Cyrillinux/attiny2313usbkeys/eagle/gamekeys.png

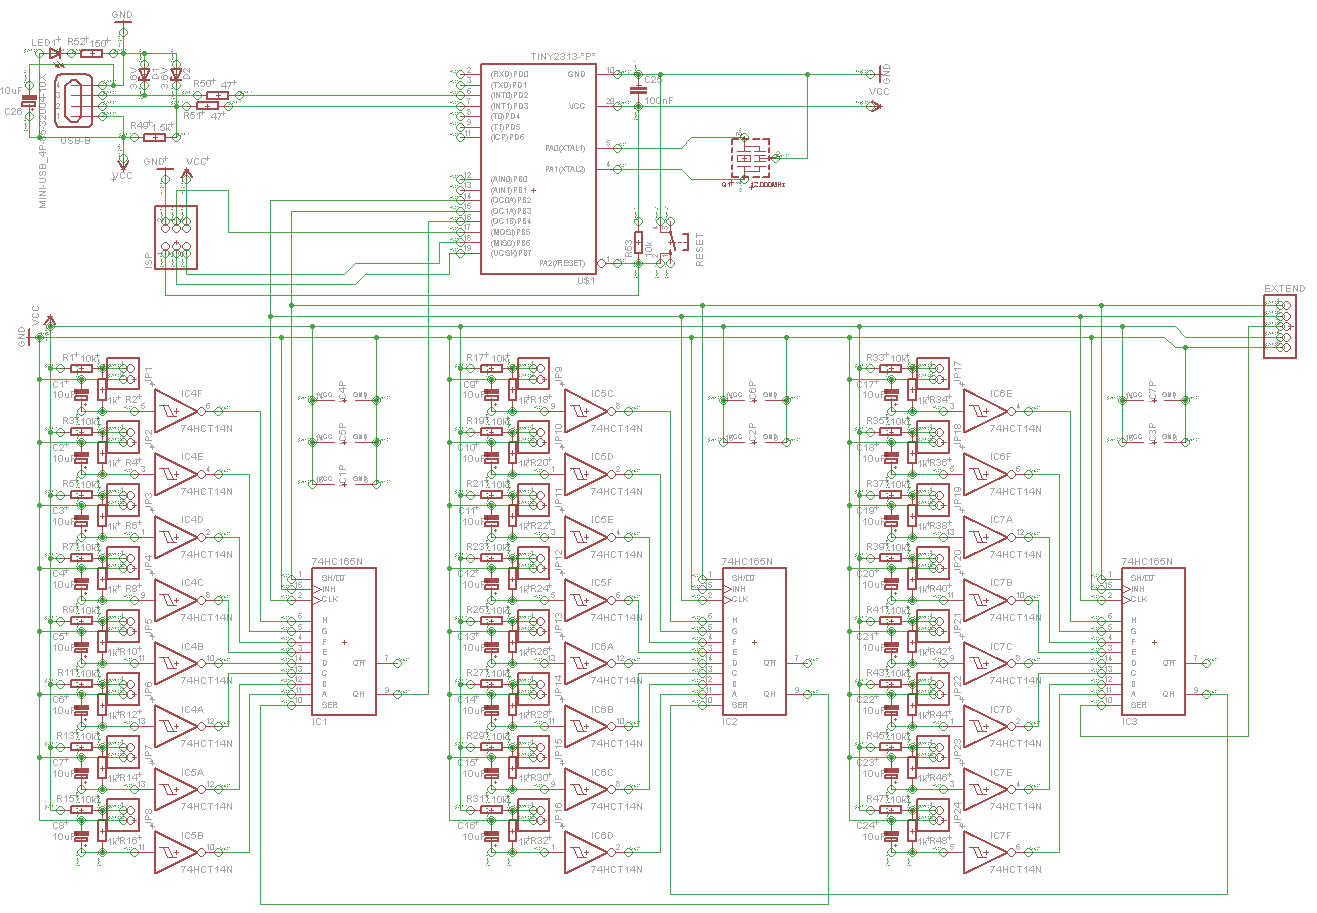
eagle/gamekeys.png
