Cyrillinux/attiny2313usbkeys/eagle/gamekeys.sch

## EAGLE design eagle/gamekeys.sch (2014-09-08)

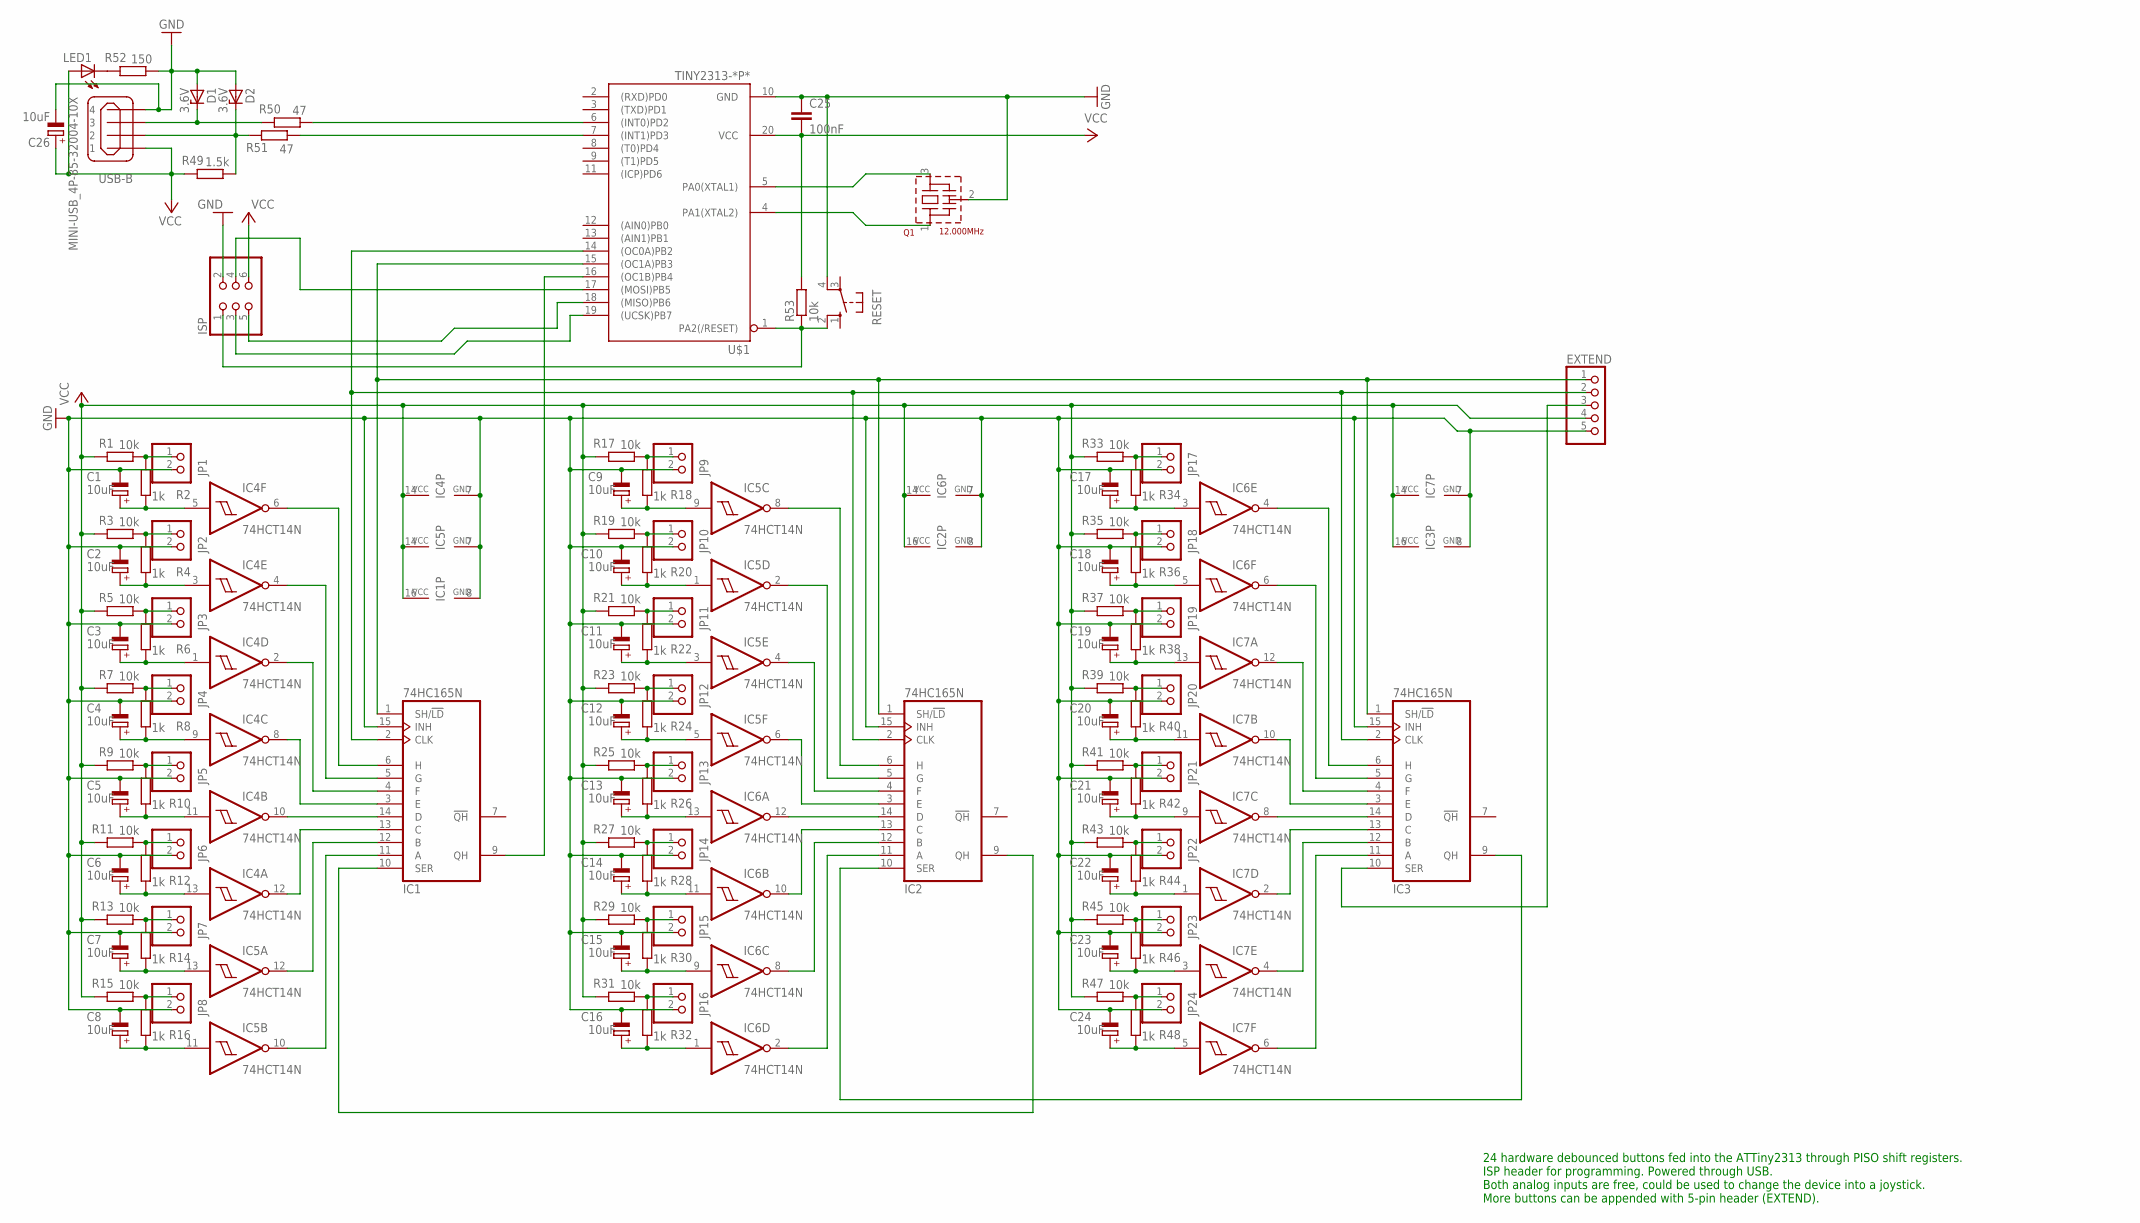
[picture p2: schematic gamekeys.sch]

Parts:
C1, C2, C3, C4, C5, C6, C7, C8, C9, C10, C11, C12, C13, C14, C15, C16, C17, C18, C19, C20, C21, C22, C23, C24: 10uF; E1,8-4
C25: 100nF; C025-024X044
C26: 10uF; E2-4
D1, D2: 3.6V; DO35Z10
EXTEND: PINHD-1X5; 1X05
IC1, IC2, IC3: 74HC165N; DIL16
IC4, IC5, IC6, IC7: 74HCT14N; DIL14
ISP: PINHD-2X3; 2X03
JP1, JP2, JP3, JP4, JP5, JP6, JP7, JP8, JP9, JP10, JP11, JP12, JP13, JP14, JP15, JP16, JP17, JP18, JP19, JP20, JP21, JP22, JP23, JP24: PINHD-1X2; 1X02
LED1: LEDLZR181; LZR181
Q1: 12.000MHz; CSTLS_G8
R1, R3, R5, R7, R9, R11, R13, R15, R17, R19, R21, R23, R25, R27, R29, R31, R33, R35, R37, R39, R41, R43, R45, R47: 10k; 0204V
R2, R4, R6, R8, R10, R12, R14, R16, R18, R20, R22, R24, R26, R28, R30, R32, R34, R36, R38, R40, R42, R44, R46, R48: 1k; 0204V
R49: 1.5k; 0204V
R50, R51: 47; 0204V
R52: 150; 0204V
R53: 10k; 0207/7
RESET: 10-XX; B3F-10XX
U$1: TINY2313-*P*; DIL20
USB-B: MINI-USB_4P-85-32004-10X; 85-32004-10X

Connections:
GND: C1.-, C2.-, C3.-, C4.-, C5.-, C6.-, C7.-, C8.-, C9.-, C10.-, C11.-, C12.-, C13.-, C14.-, C15.-, C16.-, C17.-, C18.-, C19.-, C20.-, C21.-, C22.-, C23.-, C24.-, C25.1, C26.-, D1.A, D2.A, EXTEND.5, IC1.8 (GND), IC1.15 (INH), IC2.8 (GND), IC2.15 (INH), IC3.8 (GND), IC3.15 (INH), IC4.7 (GND), IC5.7 (GND), IC6.7 (GND), IC7.7 (GND), ISP.2, JP1.2, JP2.2, JP3.2, JP4.2, JP5.2, JP6.2, JP7.2, JP8.2, JP9.2, JP10.2, JP11.2, JP12.2, JP13.2, JP14.2, JP15.2, JP16.2, JP17.2, JP18.2, JP19.2, JP20.2, JP21.2, JP22.2, JP23.2, JP24.2, Q1.2 (VSS), R52.1, RESET.4 (P1), U$1.10 (GND), USB-B.4
GND2: C16.+, IC6.1 (I), R32.1
GND4: C24.+, IC7.5 (I), R48.1
GND6: C8.+, IC5.11 (I), R16.1
unnamed: JP1.1, R1.1, R2.2
unnamed: JP2.1, R3.1, R4.2
unnamed: C1.+, IC4.5 (I), R2.1
unnamed: JP7.1, R13.1, R14.2
unnamed: JP3.1, R5.1, R6.2
unnamed: C7.+, IC5.13 (I), R14.1
unnamed: JP4.1, R7.1, R8.2
unnamed: JP8.1, R15.1, R16.2
unnamed: JP5.1, R9.1, R10.2
unnamed: C6.+, IC4.13 (I), R12.1
unnamed: JP6.1, R11.1, R12.2
unnamed: C5.+, IC4.11 (I), R10.1
unnamed: C4.+, IC4.9 (I), R8.1
unnamed: C3.+, IC4.1 (I), R6.1
unnamed: C2.+, IC4.3 (I), R4.1
unnamed: IC1.11 (A), IC5.10 (O)
unnamed: IC1.12 (B), IC5.12 (O)
unnamed: IC1.13 (C), IC4.12 (O)
unnamed: IC1.14 (D), IC4.10 (O)
unnamed: IC1.3 (E), IC4.8 (O)
unnamed: IC1.4 (F), IC4.2 (O)
unnamed: IC1.5 (G), IC4.4 (O)
unnamed: IC1.6 (H), IC4.6 (O)
unnamed: JP9.1, R17.1, R18.2
unnamed: C9.+, IC5.9 (I), R18.1
unnamed: JP10.1, R19.1, R20.2
unnamed: JP11.1, R21.1, R22.2
unnamed: JP12.1, R23.1, R24.2
unnamed: JP13.1, R25.1, R26.2
unnamed: JP14.1, R27.1, R28.2
unnamed: JP15.1, R29.1, R30.2
unnamed: C15.+, IC6.9 (I), R30.1
unnamed: JP16.1, R31.1, R32.2
unnamed: C14.+, IC6.11 (I), R28.1
unnamed: C13.+, IC6.13 (I), R26.1
unnamed: C12.+, IC5.5 (I), R24.1
unnamed: C11.+, IC5.3 (I), R22.1
unnamed: C10.+, IC5.1 (I), R20.1
unnamed: IC2.11 (A), IC6.2 (O)
unnamed: IC2.12 (B), IC6.8 (O)
unnamed: IC2.13 (C), IC6.10 (O)
unnamed: IC2.14 (D), IC6.12 (O)
unnamed: IC2.3 (E), IC5.6 (O)
unnamed: IC2.4 (F), IC5.4 (O)
unnamed: IC2.5 (G), IC5.2 (O)
unnamed: IC2.6 (H), IC5.8 (O)
unnamed: JP17.1, R33.1, R34.2
unnamed: C17.+, IC6.3 (I), R34.1
unnamed: JP18.1, R35.1, R36.2
unnamed: JP19.1, R37.1, R38.2
unnamed: JP20.1, R39.1, R40.2
unnamed: JP21.1, R41.1, R42.2
unnamed: JP22.1, R43.1, R44.2
unnamed: JP23.1, R45.1, R46.2
unnamed: C23.+, IC7.3 (I), R46.1
unnamed: JP24.1, R47.1, R48.2
unnamed: C22.+, IC7.1 (I), R44.1
unnamed: C21.+, IC7.9 (I), R42.1
unnamed: C20.+, IC7.11 (I), R40.1
unnamed: C19.+, IC7.13 (I), R38.1
unnamed: C18.+, IC6.5 (I), R36.1
unnamed: IC3.11 (A), IC7.6 (O)
unnamed: IC3.12 (B), IC7.4 (O)
unnamed: IC3.13 (C), IC7.2 (O)
unnamed: IC3.14 (D), IC7.8 (O)
unnamed: IC3.3 (E), IC7.10 (O)
unnamed: IC3.4 (F), IC7.12 (O)
unnamed: IC3.5 (G), IC6.6 (O)
unnamed: IC3.6 (H), IC6.4 (O)
unnamed: EXTEND.2, IC1.2 (CLK), IC2.2 (CLK), IC3.2 (CLK), U$1.14 ((OC0A)PB2)
unnamed: EXTEND.1, IC1.1 (SH/!LD), IC2.1 (SH/!LD), IC3.1 (SH/!LD), U$1.15 ((OC1A)PB3)
unnamed: ISP.1, R53.1, RESET.2 (S1), U$1.1 (PA2(/RESET))
unnamed: Q1.3, U$1.5 (PA0(XTAL1))
unnamed: Q1.1, U$1.4 (PA1(XTAL2))
unnamed: IC2.10 (SER), IC3.9 (QH)
unnamed: IC1.10 (SER), IC2.9 (QH)
unnamed: IC1.9 (QH), U$1.16 ((OC1B)PB4)
unnamed: D1.C, R50.2, USB-B.3
unnamed: EXTEND.3, IC3.10 (SER)
unnamed: ISP.4, U$1.17 ((MOSI)PB5)
unnamed: ISP.3, U$1.19 ((UCSK)PB7)
unnamed: D2.C, R49.1, R51.2, USB-B.2
unnamed: R50.1, U$1.6 ((INT0)PD2)
unnamed: R51.1, U$1.7 ((INT1)PD3)
unnamed: LED1.K (C), R52.2
unnamed: ISP.5, U$1.18 ((MISO)PB6)
VCC: C25.2, C26.+, EXTEND.4, IC1.16 (VCC), IC2.16 (VCC), IC3.16 (VCC), IC4.14 (VCC), IC5.14 (VCC), IC6.14 (VCC), IC7.14 (VCC), ISP.6, LED1.A, R1.2, R3.2, R5.2, R7.2, R9.2, R11.2, R13.2, R15.2, R17.2, R19.2, R21.2, R23.2, R25.2, R27.2, R29.2, R31.2, R33.2, R35.2, R37.2, R39.2, R41.2, R43.2, R45.2, R47.2, R49.2, R53.2, U$1.20 (VCC), USB-B.1

Notes on the sheet:
24 hardware debounced buttons fed into the ATTiny2313 through PISO shift registers. ISP header for programming. Powered through USB. Both analog inputs are free, could be used to change the device into a joystick. More buttons can be appended with 5-pin header (EXTEND).
